Aspro1982/Soldering-Station/PCB/SchematicAndAssembly.PDF

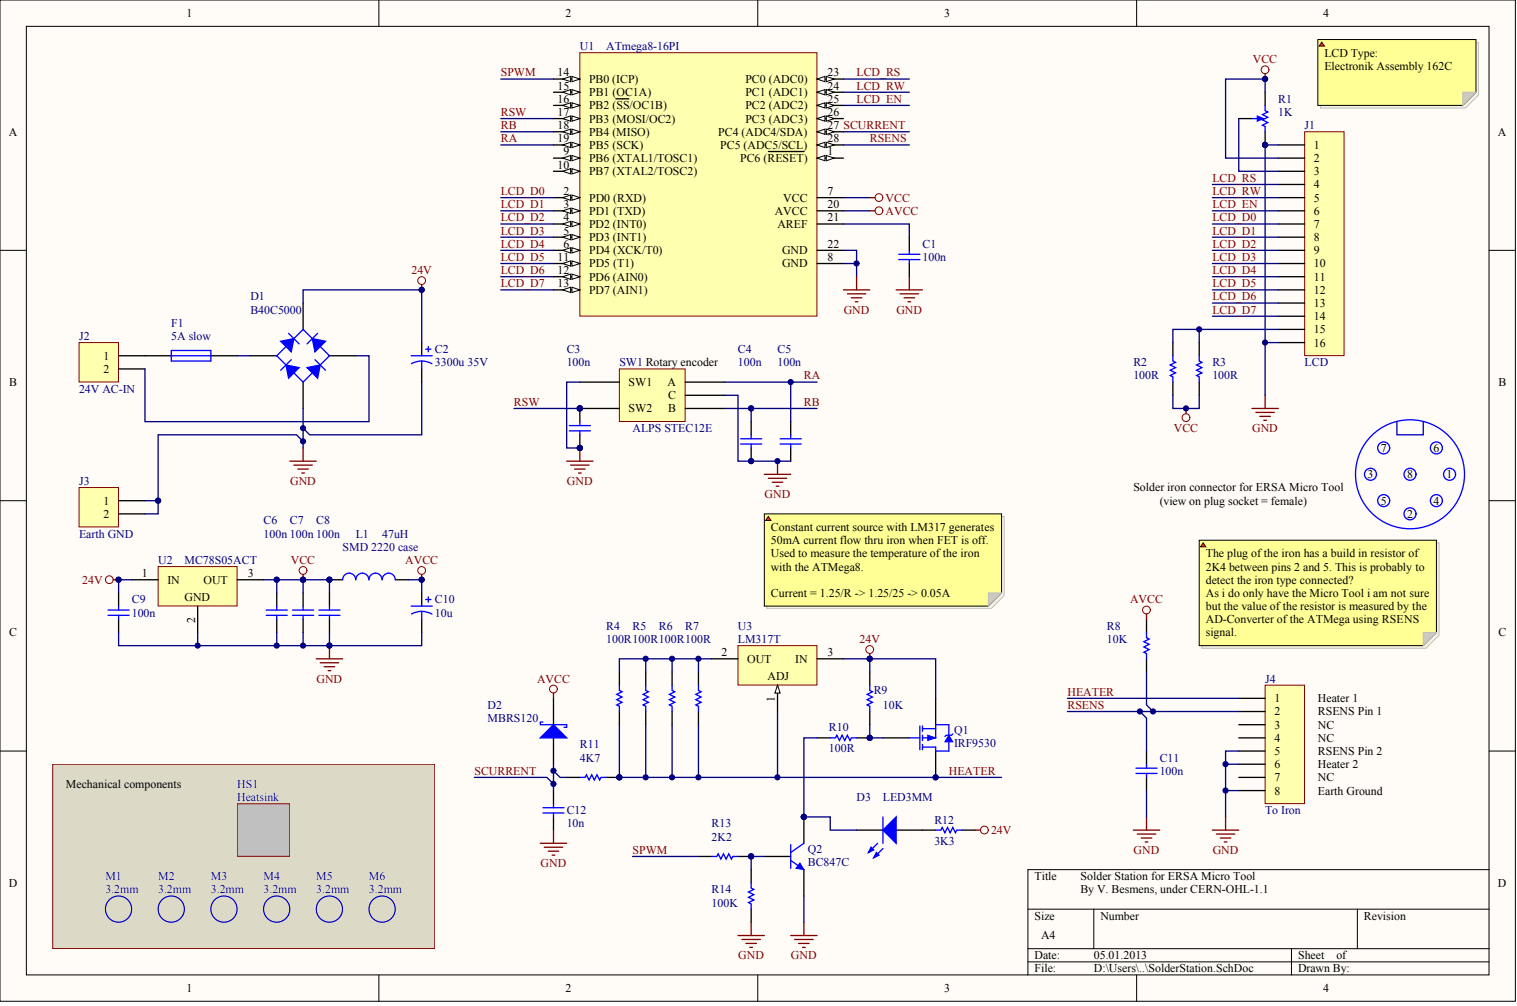
[picture p1: page 1]

Solder iron connector for ERSA Micro Tool
(view on plug socket = female)

Constant current source with LM317 generates
50mA current flow thru iron when FET is off.
Used to measure the temperature of the iron
with the ATMega8.

2K4 between pins 2 and 5. This is probably to
detect the iron type connected?
As i do only have the Micro Tool i am not sure
but the value of the resistor is measured by the
AD-Converter of the ATMega using RSENS
signal.

Solder Station for ERSA Micro Tool
By V. Besmens, under CERN-OHL-1.1

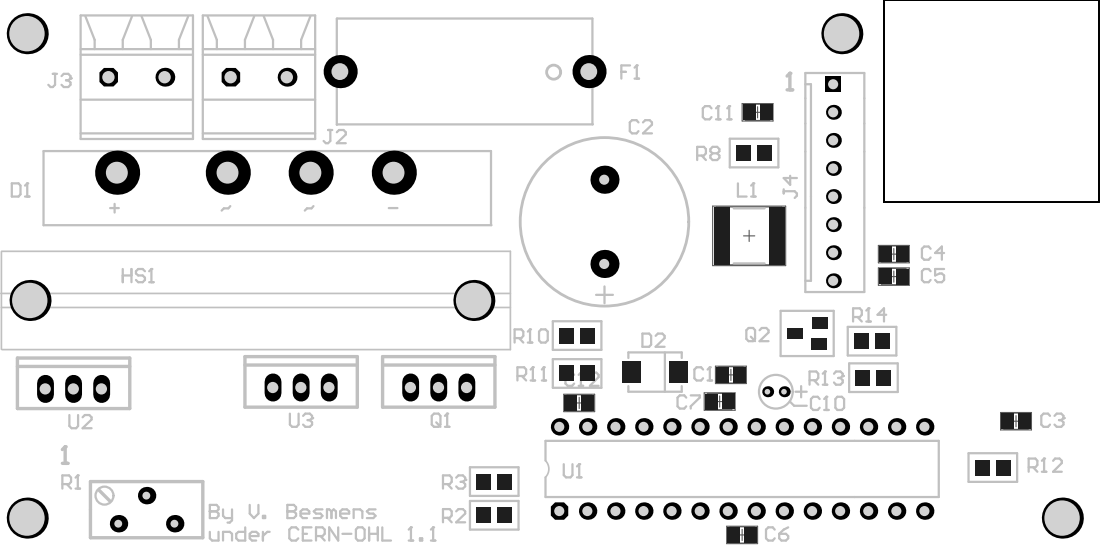
[picture p2: page 2]

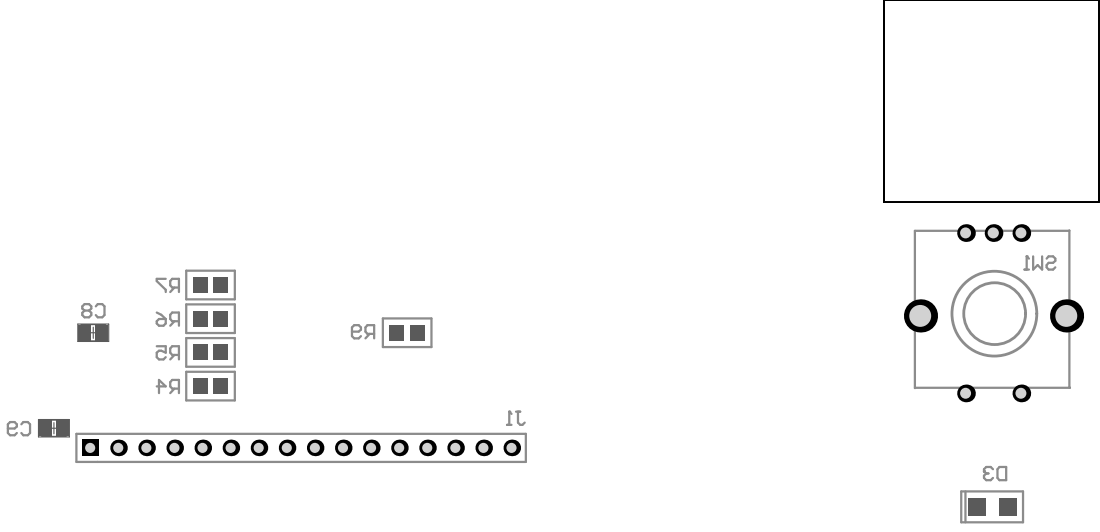
[picture p3: page 3]
