Aspro1982/Soldering-Station/(list of files, drawings)

Other design files:
PCB/AltiumDesigner/SoderStation.PcbDoc
PCB/AltiumDesigner/SolderStation.PrjPCB
PCB/AltiumDesigner/SolderStation.SchDoc
