Aspro1982/Soldering-Station/(notices)

Notices in the files:
Firmware/textdisplay.c:
This program is free software; you can redistribute it and/or modify
it under the terms of the GNU General Public License as published by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
